probably-Erwins-Cat/E-TKT/_3dprint/source/E-TKT.FCStd

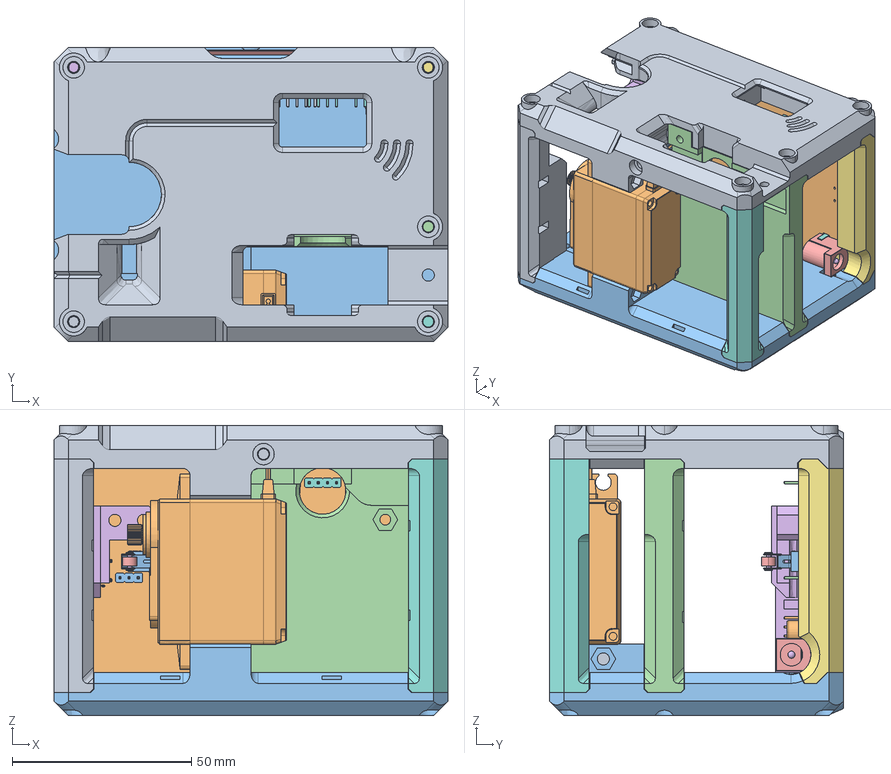
[picture p1: CAD file, 2025-10-23]
_3dprint/source/E-TKT.FCStd
110.0 x 82.0 x 81.0 mm
E-TKT_025-structure_J_top
MG-995
A_bottom
B_wall
optional-electronics-cover
F_pillar
G_pillar
D_pillar
E_pillar
C_0603_1608Metric015
LED_0603_1608Metric012
R_0603_1608Metric029
SSOP-20_3.9x8.7mm_P0.635mm001
C_0603_1608Metric016
C_0603_1608Metric017
LED_0603_1608Metric013
KEY-SMD_4P-L6.0-W6.3-H3.1-LS8.0-P4.014
KEY-SMD_4P-L6.0-W6.3-H3.1-LS8.0-P4.015
R_0603_1608Metric030
R_0603_1608Metric031
R_0603_1608Metric032
R_0603_1608Metric033
SOT-224
C_0603_1608Metric018
TDFN-6_L2.0-W2.0-H0.8-P0.65
SOT-225
C_0603_1608Metric019
C_0603_1608Metric020
C_0603_1608Metric021
KEY-SMD_4P-L6.0-W6.3-H3.1-LS8.0-P4.017
KEY-SMD_4P-L6.0-W6.3-H3.1-LS8.0-P4.018
C_0603_1608Metric022
L_0805_2012Metric001
USB-TH_GT-USB-7057A
C_1210_3225Metric008
R_0603_1608Metric034
C_1210_3225Metric009
R_0603_1608Metric035
R_0603_1608Metric036
R_0603_1608Metric037
C_0603_1608Metric023
SOT-23-007
LED_0603_1608Metric014
R_0603_1608Metric038
C_1210_3225Metric010
C_0603_1608Metric024
LED_0603_1608Metric015
C_1210_3225Metric011
Fuse_0805_2012Metric001
R_0603_1608Metric039
R_0603_1608Metric040
KEY-SMD_4P-L6.0-W6.3-H3.1-LS8.0-P4.020
KEY-SMD_4P-L6.0-W6.3-H3.1-LS8.0-P4.021
LED_0603_1608Metric016
R_0603_1608Metric041
R_0603_1608Metric042
R_0603_1608Metric043
R_0603_1608Metric044
R_0603_1608Metric045
C_0603_1608Metric025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
