probably-Erwins-Cat/E-TKT/_3dprint/source/PCB-V2-BETA.step

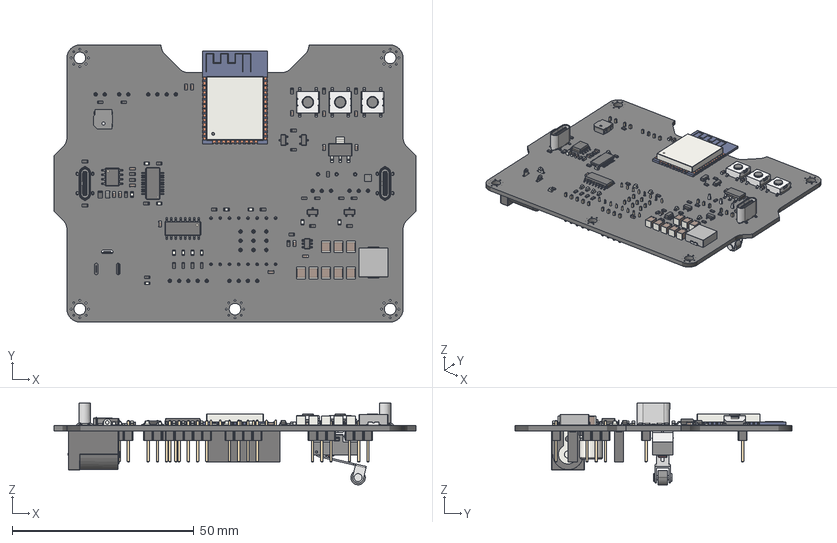
[picture p2: CAD file, 2025-10-22]
_3dprint/source/PCB-V2-BETA.step
99.6 x 76.2 x 22.5 mm
C_0603_1608Metric x 15
LED_0603_1608Metric x 12
R_0603_1608Metric x 30
SSOP-20_3.9x8.7mm_P0.635mm
KEY-SMD_4P-L6.0-W6.3-H3.1-LS8.0-P4.5 x 3
SOT-23 x 4
TDFN-6_L2.0-W2.0-H0.8-P0.65
L_0805_2012Metric
USB-TH_GT-USB-7057A x 2
C_1210_3225Metric x 8
SOT-23-6
Fuse_0805_2012Metric
SOIC-16_3.9x9.9mm_P1.27mm
SOIC-8_3.9x4.9mm_P1.27mm
IND-SMD_L8.5-W8.0_PSPMAA0803H-330M-ANP
BUZ-SMD_3P-L5.2-W5.2-H2.0-P3.50
SOT-223
ESP32-WROOM-32
PinHeader_1x03_P2.54mm_Vertical x 5
PinSocket_1x08_P2.54mm_Vertical x 2
PinHeader_1x04_P2.54mm_Vertical x 2
PinHeader_1x02_P2.54mm_Vertical x 2
BarrelJack_Horizontal
CP_Elec_6.3x7.7
PinHeader_1x05_P2.54mm_Vertical
e-tkt_PCB
