probably-Erwins-Cat/E-TKT/_electronic/e-tkt.kicad_pcb

## KiCad design _electronic/e-tkt.kicad_pcb (2025-10-24)

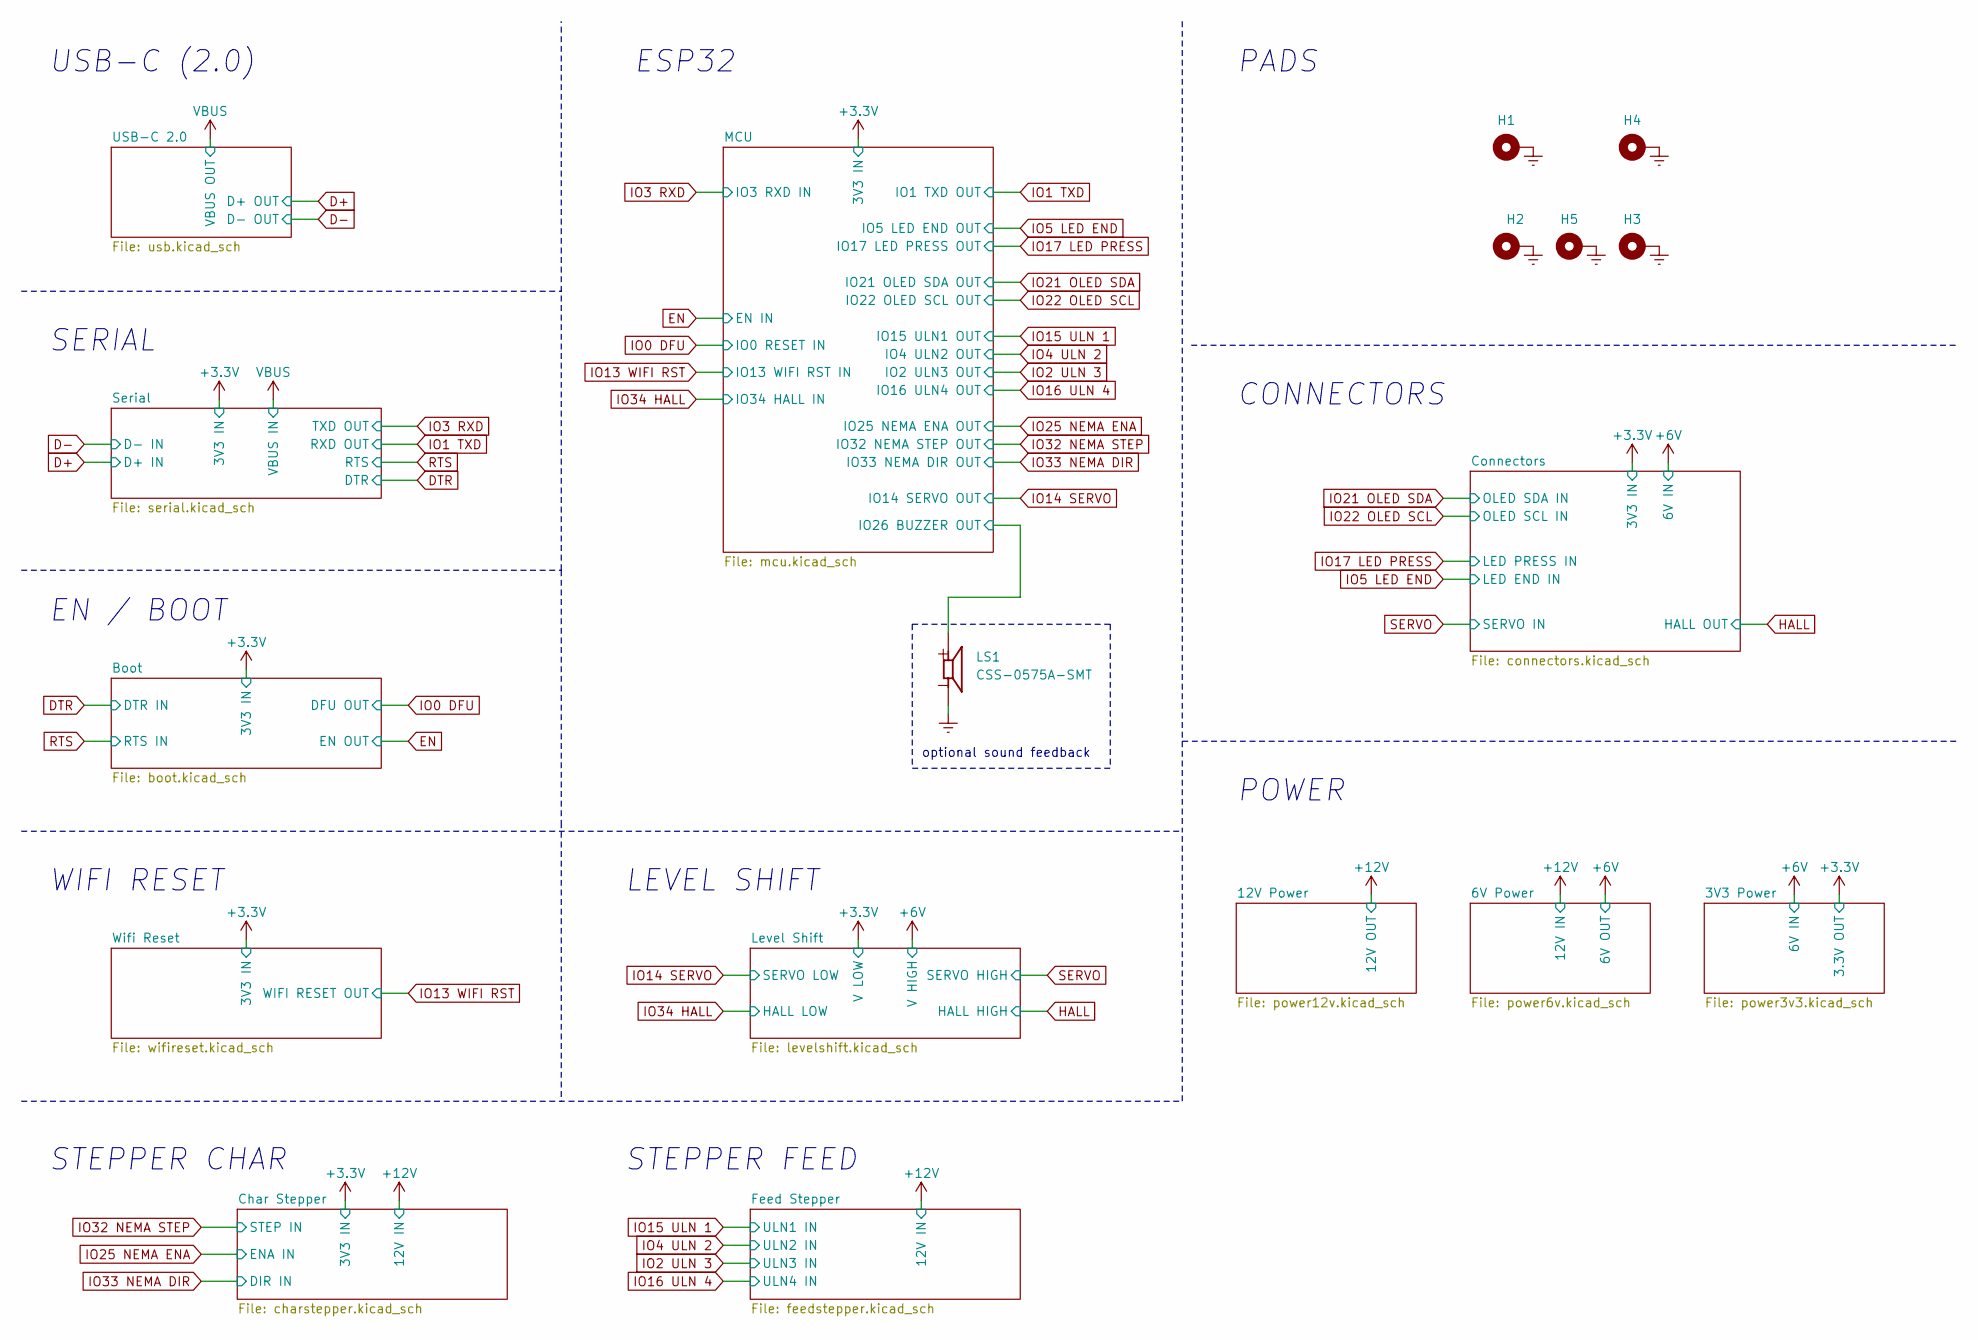
[picture p4: schematic e-tkt.kicad_sch, E-TKT v2.0 BETA]

Parts:
H1, H2, H3, H4, H5: M3; MountingHole_3.2mm_M3_Pad_Via; Mouser OK
LS1: CSS-0575A-SMT; BUZ-SMD_L5.0-W5.5-P4.60; Mouser OK

Connections:
/MCU/IO26 BUZZER OUT: LS1.1; also elsewhere on the board
GNDREF: H1.1, H2.1, H3.1, H4.1, H5.1, LS1.2; also elsewhere on the board

Notes on the sheet:
PADS
POWER
optional sound feedback
SERIAL
EN / BOOT
CONNECTORS
STEPPER CHAR
WIFI RESET
ESP32
LEVEL SHIFT
STEPPER FEED
USB-C (2.0)

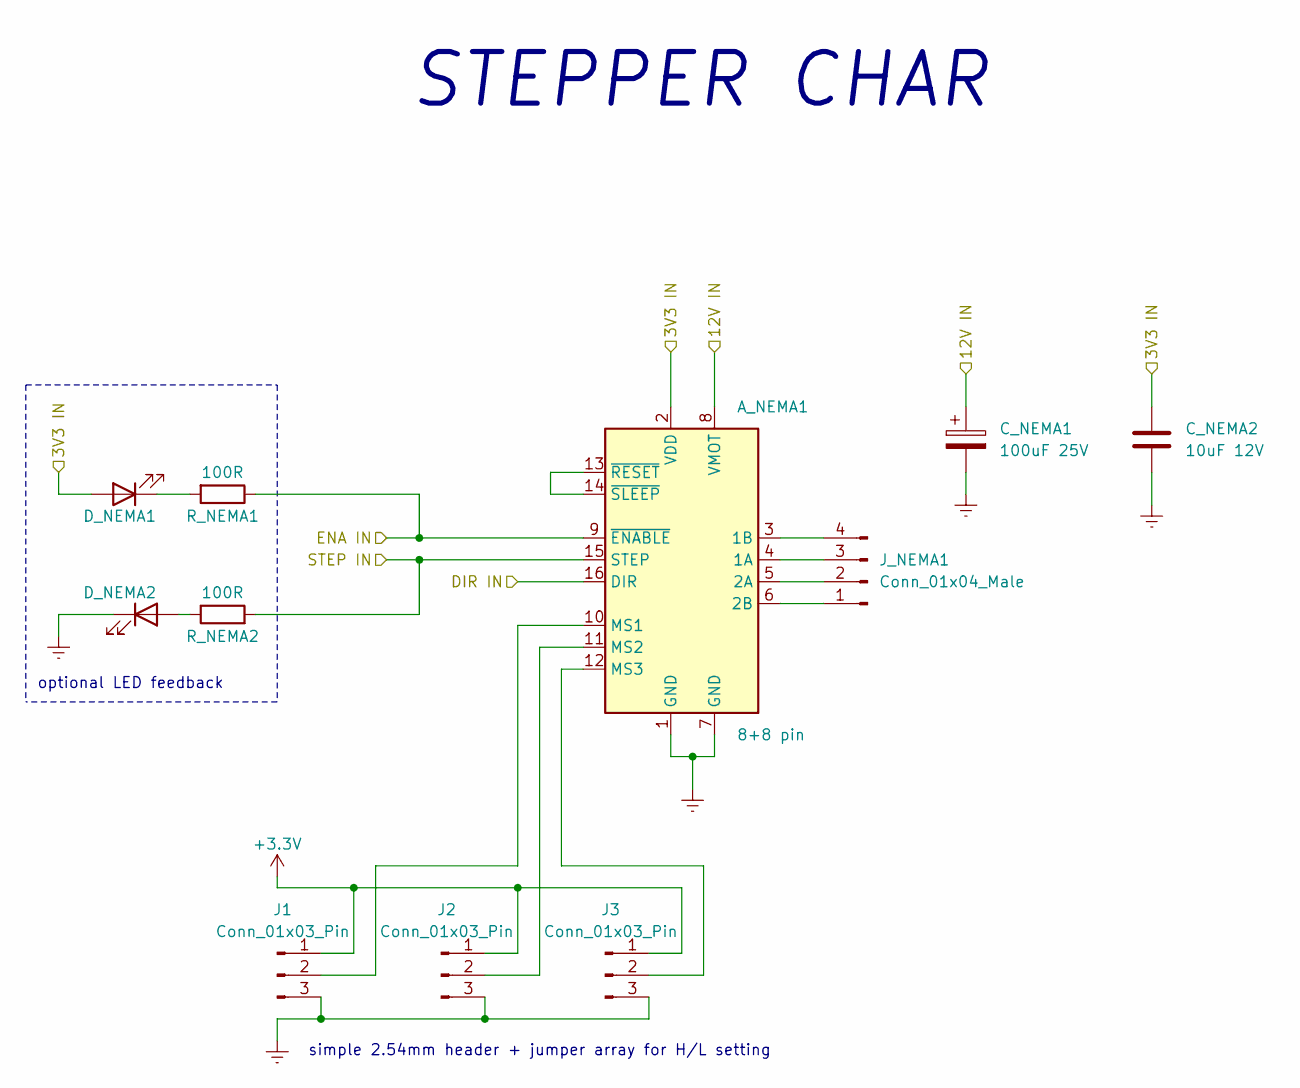
[picture p5: schematic charstepper.kicad_sch, E-TKT v2.0 BETA]

Parts:
A_NEMA1: 8+8 pin; Pololu_Breakout-16_15.2x20.3mm; Mouser OK
C_NEMA1: 100uF 25V; CP_Elec_6.3x7.7; Mouser OK
C_NEMA2: 10uF 12V; C_0603_1608Metric_Pad1.08x0.95mm_HandSolder; Mouser OK
D_NEMA1, D_NEMA2: LED white; LED_0603_1608Metric_Pad1.05x0.95mm_HandSolder; Mouser OK
J1, J2, J3: Conn_01x03_Pin; PinHeader_1x03_P2.54mm_Vertical; LCSC C2937625
J_NEMA1: Conn_01x04_Male; PinHeader_1x04_P2.54mm_Vertical; Mouser OK
R_NEMA1, R_NEMA2: 100R; R_0603_1608Metric_Pad0.98x0.95mm_HandSolder; Mouser OK

Connections:
+3.3V: A_NEMA1.2 (VDD), C_NEMA2.2, D_NEMA1.2 (A), J1.1, J2.1, J3.1; also elsewhere on the board
+12V: A_NEMA1.8 (VMOT), C_NEMA1.1; also elsewhere on the board
GNDREF: A_NEMA1.1 (GND), A_NEMA1.7 (GND), C_NEMA1.2, C_NEMA2.1, D_NEMA2.1 (K), J1.3, J2.3, J3.3; also elsewhere on the board
IO25 NEMA ENA: A_NEMA1.9 (~ENABLE), R_NEMA1.1; also elsewhere on the board
IO32 NEMA STEP: A_NEMA1.15 (STEP), R_NEMA2.2; also elsewhere on the board
IO33 NEMA DIR: A_NEMA1.16 (DIR); also elsewhere on the board
unnamed: A_NEMA1.4 (1A), J_NEMA1.3
unnamed: A_NEMA1.3 (1B), J_NEMA1.4
unnamed: A_NEMA1.5 (2A), J_NEMA1.2
unnamed: A_NEMA1.6 (2B), J_NEMA1.1
unnamed: A_NEMA1.10 (MS1), J1.2
unnamed: A_NEMA1.11 (MS2), J2.2
unnamed: A_NEMA1.12 (MS3), J3.2
unnamed: A_NEMA1.13 (~RESET), A_NEMA1.14 (~SLEEP)
unnamed: D_NEMA1.1 (K), R_NEMA1.2
unnamed: D_NEMA2.2 (A), R_NEMA2.1

Notes on the sheet:
optional LED feedback
simple 2.54mm header + jumper array for H/L setting
STEPPER CHAR

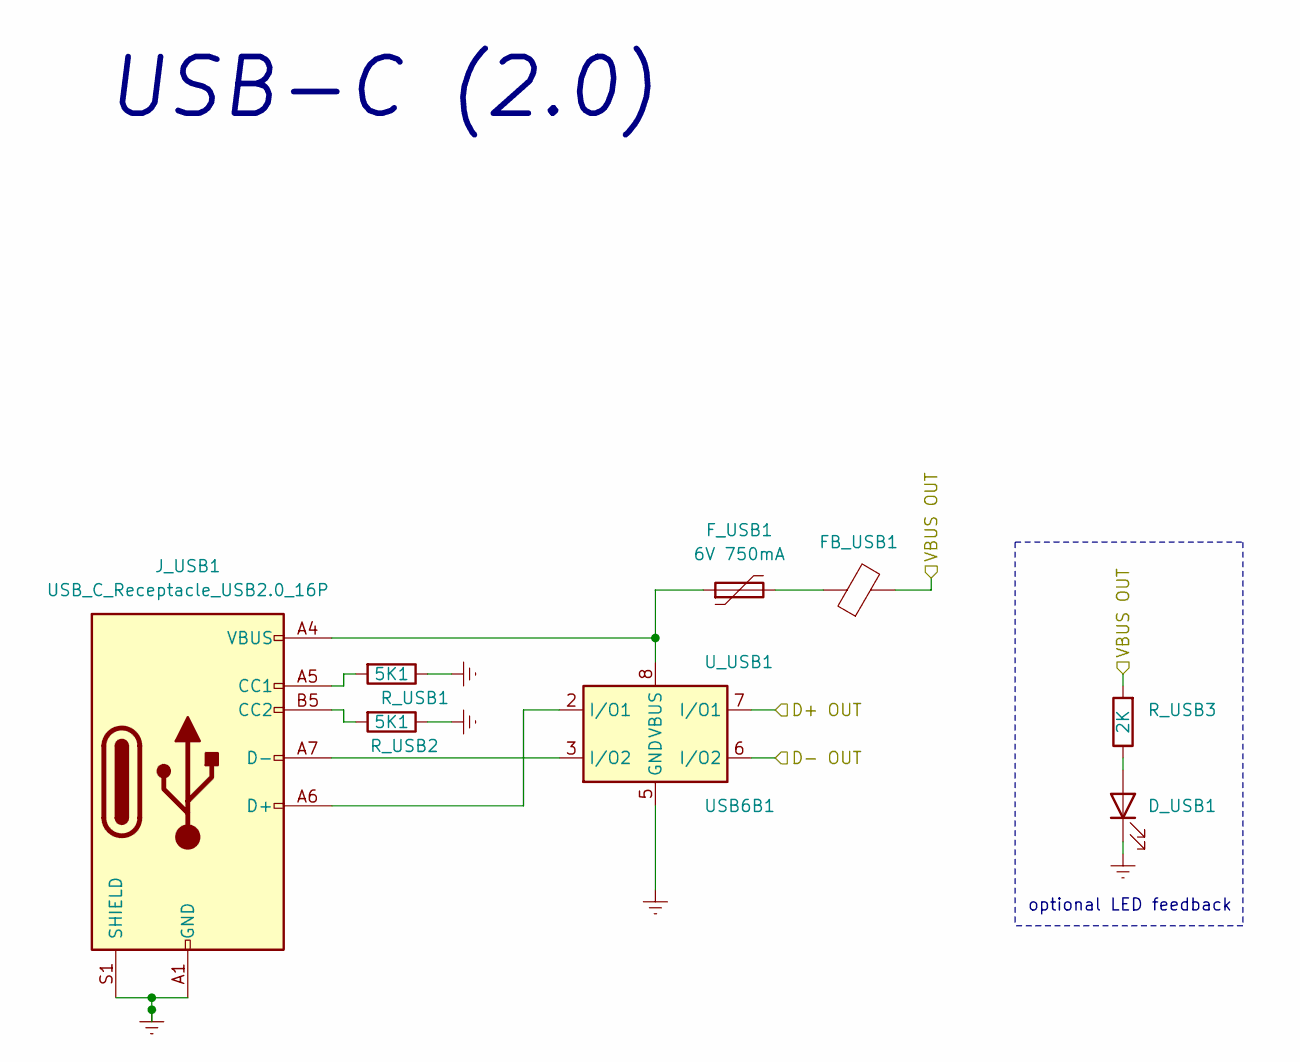
[picture p6: schematic usb.kicad_sch, E-TKT v2.0 BETA]

Parts:
D_USB1: LED white; LED_0603_1608Metric_Pad1.05x0.95mm_HandSolder; Mouser OK
FB_USB1: 40 Ohms @ 100 MHz 1 Power; L_0805_2012Metric_Pad1.05x1.20mm_HandSolder; Mouser OK
F_USB1: 6V 750mA; Fuse_0805_2012Metric_Pad1.15x1.40mm_HandSolder; Mouser OK
J_USB1: USB_C_Receptacle_USB2.0_16P; USB-TH_GT-USB-7057A; LCSC C22383830
R_USB1, R_USB2: 5K1; R_0603_1608Metric_Pad0.98x0.95mm_HandSolder; Mouser OK
R_USB3: 2K; R_0603_1608Metric_Pad0.98x0.95mm_HandSolder; Mouser OK
U_USB1: USB6B1; SOIC-8_3.9x4.9mm_P1.27mm; Mouser OK

Connections:
D+: U_USB1.7 (I/O1); also elsewhere on the board
D-: U_USB1.6 (I/O2); also elsewhere on the board
GNDREF: D_USB1.1 (K), J_USB1.A1 (GND), J_USB1.S1 (SHIELD), R_USB1.1, R_USB2.1, U_USB1.4 (GND), U_USB1.5 (GND); also elsewhere on the board
unnamed: D_USB1.2 (A), R_USB3.1
unnamed: FB_USB1.1, F_USB1.2
unnamed: F_USB1.1, J_USB1.A4 (VBUS), U_USB1.1 (VBUS), U_USB1.8 (VBUS)
unnamed: J_USB1.A5 (CC1), R_USB1.2
unnamed: J_USB1.B5 (CC2), R_USB2.2
unnamed: J_USB1.A6 (D+), U_USB1.2 (I/O1)
unnamed: J_USB1.A7 (D-), U_USB1.3 (I/O2)
VBUS: FB_USB1.2, R_USB3.2; also elsewhere on the board

Notes on the sheet:
USB-C (2.0)
optional LED feedback

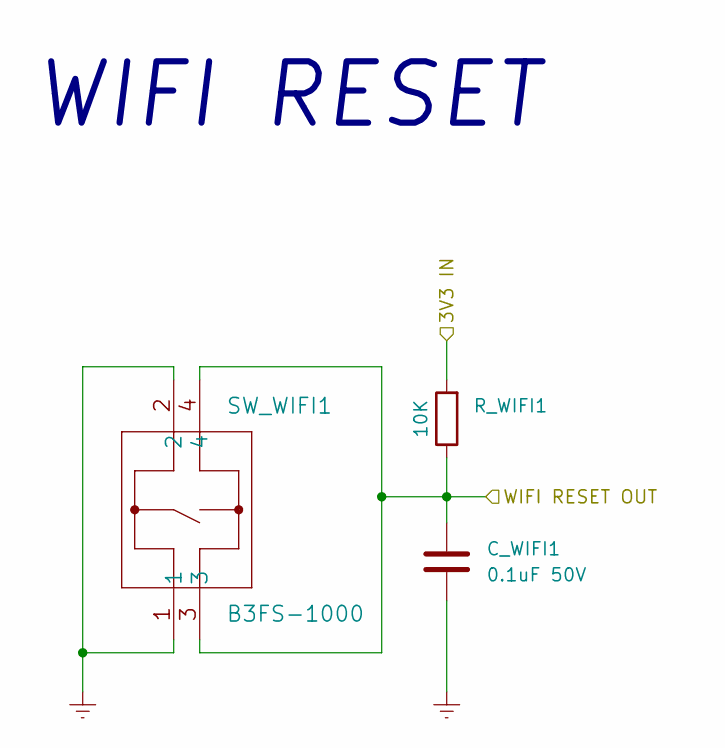
[picture p7: schematic wifireset.kicad_sch, E-TKT v2.0 BETA]

Parts:
C_WIFI1: 0.1uF 50V; C_0603_1608Metric_Pad1.08x0.95mm_HandSolder; Mouser OK
R_WIFI1: 10K; R_0603_1608Metric_Pad0.98x0.95mm_HandSolder; Mouser OK
SW_WIFI1: B3FS-1000; KEY-SMD_4P-L6.0-W6.3-P4.50-LS8.0; Mouser OK

Connections:
+3.3V: R_WIFI1.2; also elsewhere on the board
GNDREF: C_WIFI1.1, SW_WIFI1.1, SW_WIFI1.2; also elsewhere on the board
IO13 WIFI RST: C_WIFI1.2, R_WIFI1.1, SW_WIFI1.3, SW_WIFI1.4; also elsewhere on the board

Notes on the sheet:
WIFI RESET

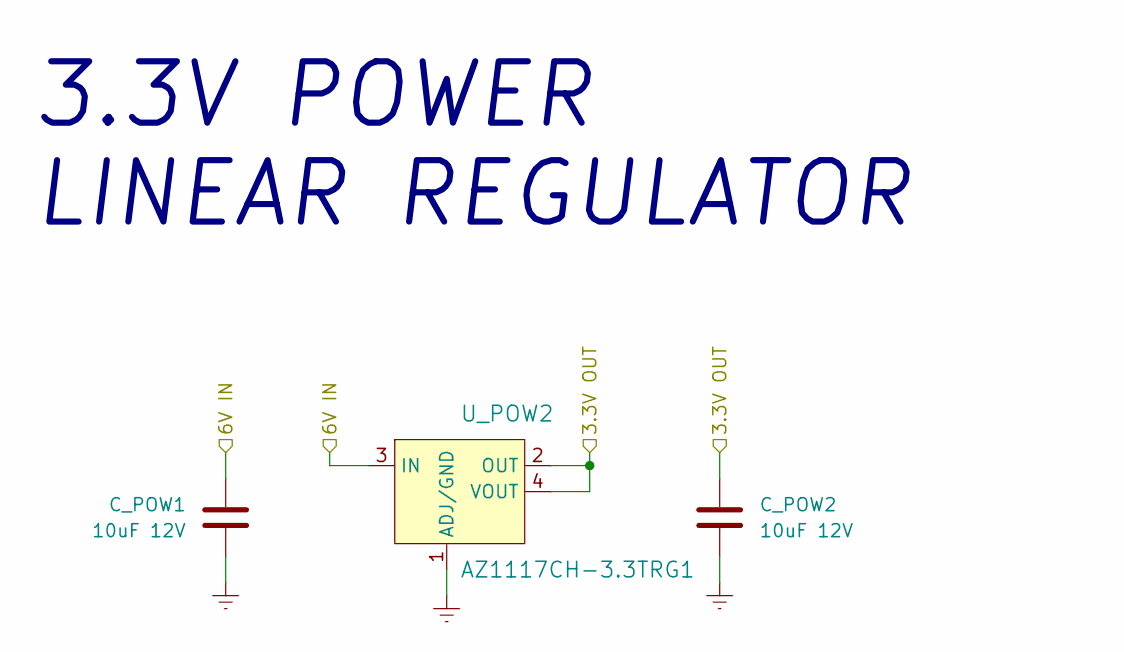
[picture p8: schematic power3v3.kicad_sch, E-TKT v2.0 BETA]

Parts:
C_POW1, C_POW2: 10uF 12V; C_0603_1608Metric_Pad1.08x0.95mm_HandSolder; Mouser OK
U_POW2: AZ1117CH-3.3TRG1; SOT-223; Mouser OK

Connections:
+3.3V: C_POW2.1, U_POW2.2 (OUT), U_POW2.4 (VOUT); also elsewhere on the board
+6V: C_POW1.1, U_POW2.3 (IN); also elsewhere on the board
GNDREF: C_POW1.2, C_POW2.2, U_POW2.1 (ADJ/GND); also elsewhere on the board

Notes on the sheet:
3.3V POWER LINEAR REGULATOR

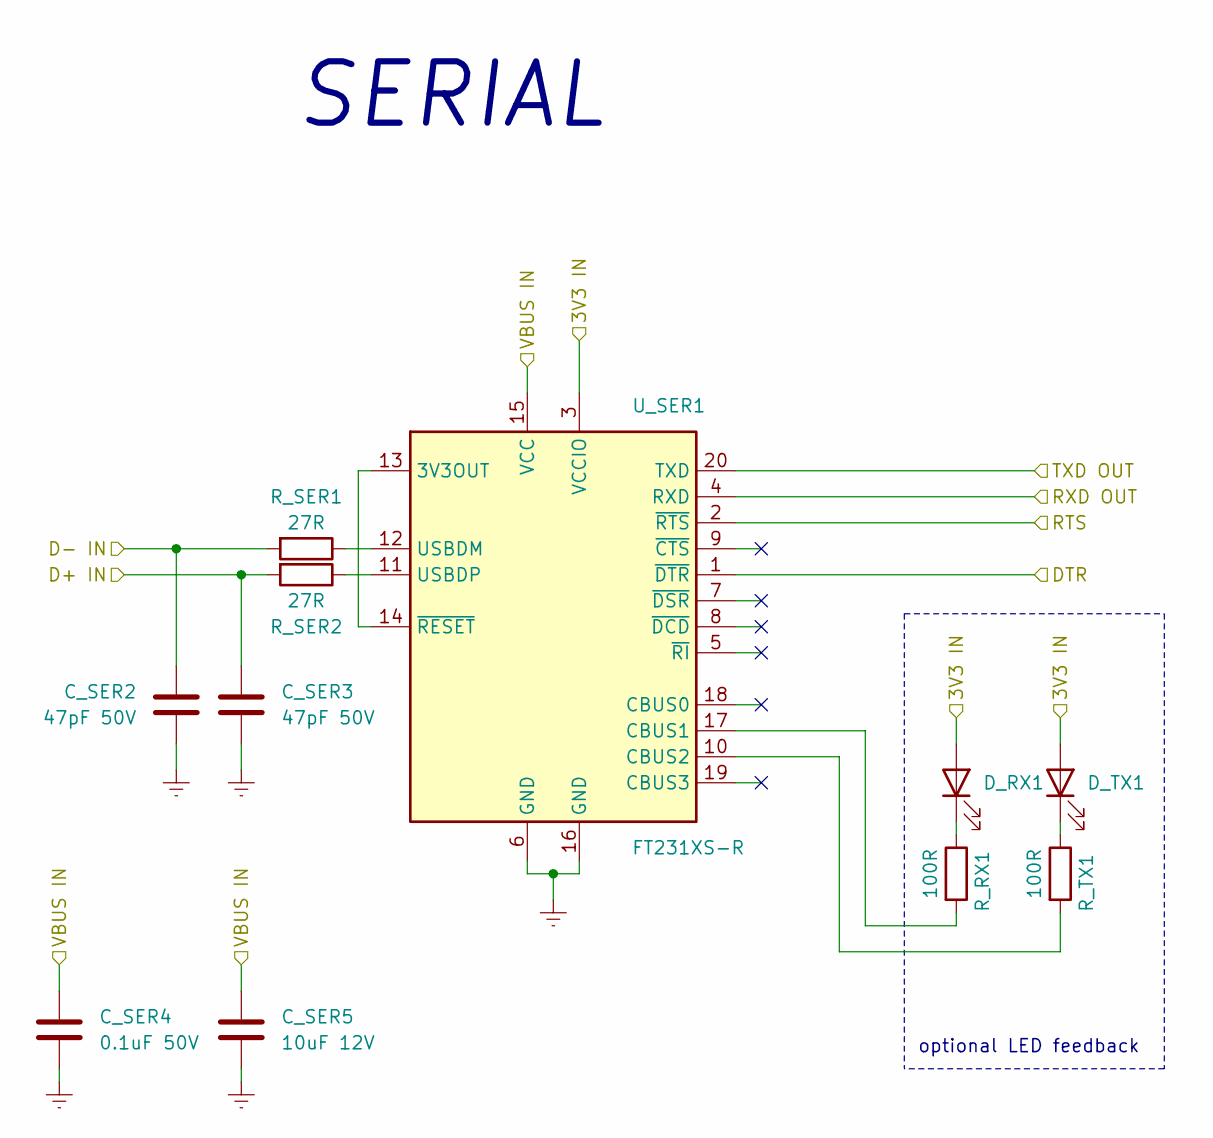
[picture p9: schematic serial.kicad_sch, E-TKT v2.0 BETA]

Parts:
C_SER2, C_SER3: 47pF 50V; C_0603_1608Metric_Pad1.08x0.95mm_HandSolder; Mouser OK
C_SER4: 0.1uF 50V; C_0603_1608Metric_Pad1.08x0.95mm_HandSolder; Mouser OK
C_SER5: 10uF 12V; C_0603_1608Metric_Pad1.08x0.95mm_HandSolder; Mouser OK
D_RX1: LED white; LED_0603_1608Metric_Pad1.05x0.95mm_HandSolder; Mouser OK
D_TX1: LED white; LED_0603_1608Metric_Pad1.05x0.95mm_HandSolder; Mouser OK
R_RX1: 100R; R_0603_1608Metric_Pad0.98x0.95mm_HandSolder; Mouser OK
R_SER1, R_SER2: 27R; R_0603_1608Metric_Pad0.98x0.95mm_HandSolder; Mouser OK
R_TX1: 100R; R_0603_1608Metric_Pad0.98x0.95mm_HandSolder; Mouser OK
U_SER1: FT231XS-R; SSOP-20_3.9x8.7mm_P0.635mm; Mouser OK

Connections:
+3.3V: D_RX1.2 (A), D_TX1.2 (A), U_SER1.3 (VCCIO); also elsewhere on the board
D+: C_SER3.2, R_SER2.2; also elsewhere on the board
D-: C_SER2.2, R_SER1.2; also elsewhere on the board
DTR: U_SER1.1 (~DTR); also elsewhere on the board
GNDREF: C_SER2.1, C_SER3.1, C_SER4.2, C_SER5.1, U_SER1.6 (GND), U_SER1.16 (GND); also elsewhere on the board
IO1 TXD: U_SER1.4 (RXD); also elsewhere on the board
IO3 RXD: U_SER1.20 (TXD); also elsewhere on the board
unnamed: D_RX1.1 (K), R_RX1.1
unnamed: D_TX1.1 (K), R_TX1.1
unnamed: U_SER1.13 (3V3OUT), U_SER1.14 (~RESET)
unnamed: R_RX1.2, U_SER1.17 (CBUS1)
unnamed: R_TX1.2, U_SER1.10 (CBUS2)
unnamed: R_SER1.1, U_SER1.12 (USBDM)
unnamed: R_SER2.1, U_SER1.11 (USBDP)
RTS: U_SER1.2 (~RTS); also elsewhere on the board
VBUS: C_SER4.1, C_SER5.2, U_SER1.15 (VCC); also elsewhere on the board

Notes on the sheet:
SERIAL
optional LED feedback

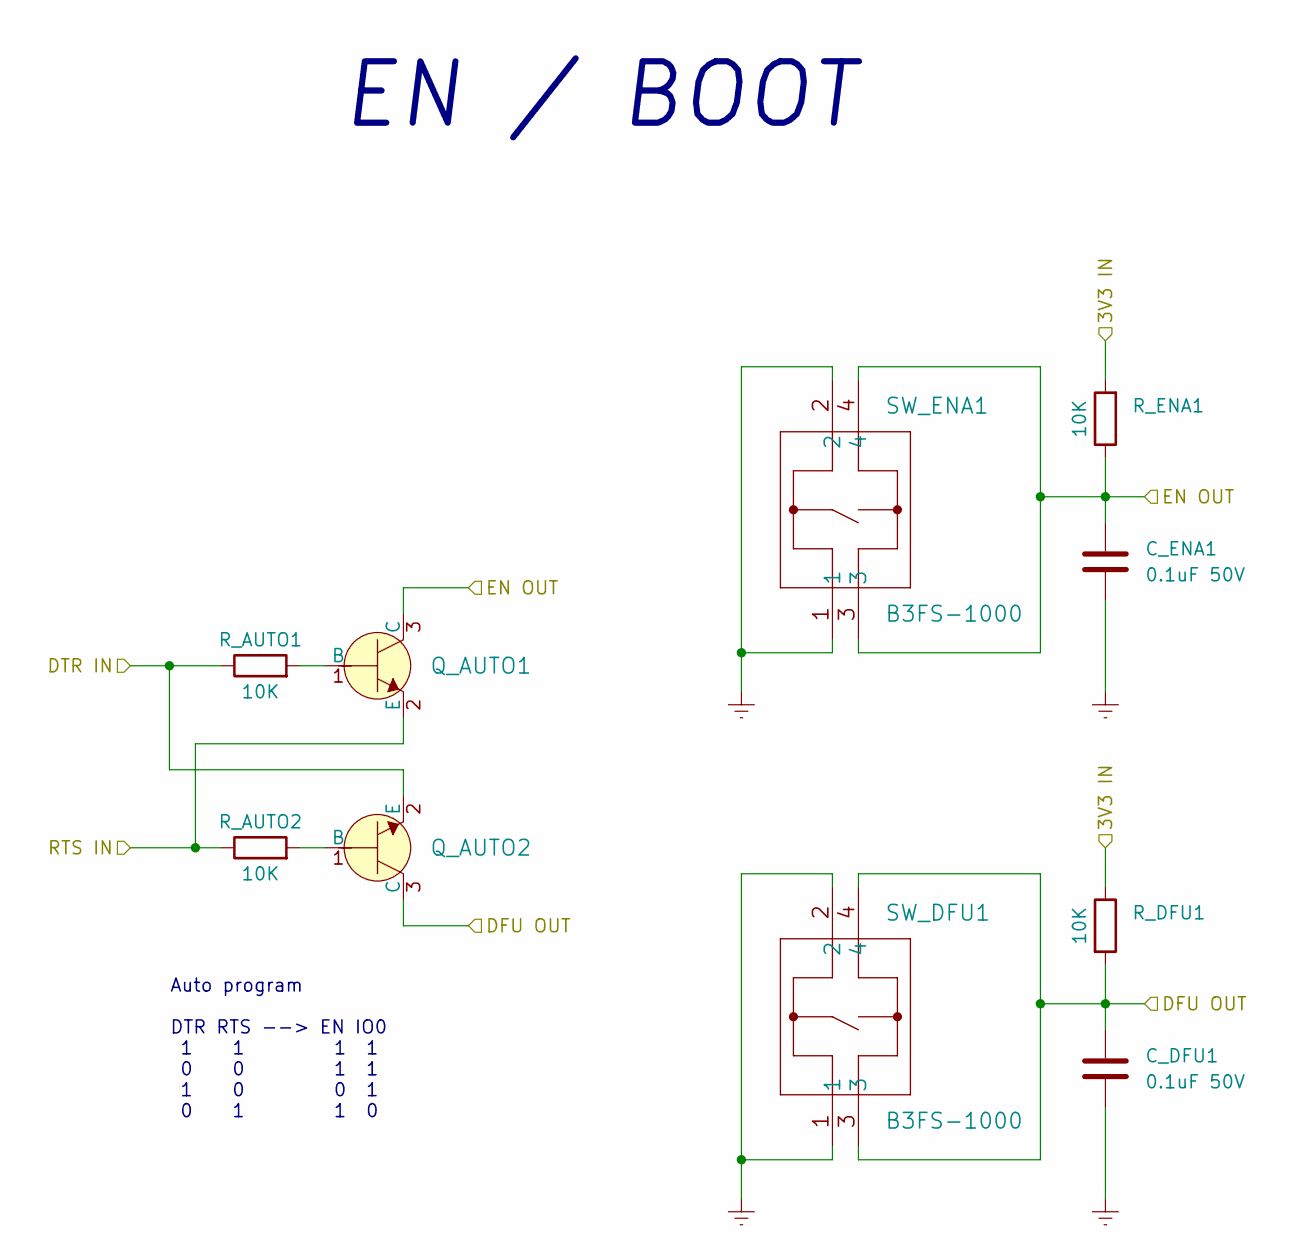
[picture p10: schematic boot.kicad_sch, E-TKT v2.0 BETA]

Parts:
C_DFU1: 0.1uF 50V; C_0603_1608Metric_Pad1.08x0.95mm_HandSolder; Mouser OK
C_ENA1: 0.1uF 50V; C_0603_1608Metric_Pad1.08x0.95mm_HandSolder; Mouser OK
Q_AUTO1, Q_AUTO2: SS8050; SOT-23_Handsoldering; Mouser OK
R_AUTO1, R_AUTO2: 10K; R_0603_1608Metric_Pad0.98x0.95mm_HandSolder; Mouser OK
R_DFU1: 10K; R_0603_1608Metric_Pad0.98x0.95mm_HandSolder; Mouser OK
R_ENA1: 10K; R_0603_1608Metric_Pad0.98x0.95mm_HandSolder; Mouser OK
SW_DFU1: B3FS-1000; KEY-SMD_4P-L6.0-W6.3-P4.50-LS8.0; Mouser OK
SW_ENA1: B3FS-1000; KEY-SMD_4P-L6.0-W6.3-P4.50-LS8.0; Mouser OK

Connections:
+3.3V: R_DFU1.1, R_ENA1.2; also elsewhere on the board
DTR: Q_AUTO2.2 (E), R_AUTO1.1; also elsewhere on the board
EN: C_ENA1.2, Q_AUTO1.3 (C), R_ENA1.1, SW_ENA1.3, SW_ENA1.4; also elsewhere on the board
GNDREF: C_DFU1.1, C_ENA1.1, SW_DFU1.1, SW_DFU1.2, SW_ENA1.1, SW_ENA1.2; also elsewhere on the board
IO0 DFU: C_DFU1.2, Q_AUTO2.3 (C), R_DFU1.2, SW_DFU1.3, SW_DFU1.4; also elsewhere on the board
unnamed: Q_AUTO1.1 (B), R_AUTO1.2
unnamed: Q_AUTO2.1 (B), R_AUTO2.2
RTS: Q_AUTO1.2 (E), R_AUTO2.1; also elsewhere on the board

Notes on the sheet:
Auto program DTR RTS --> EN IO0 1 1 1 1 0 0 1 1 1 0 0 1 0 1 1 0
EN / BOOT

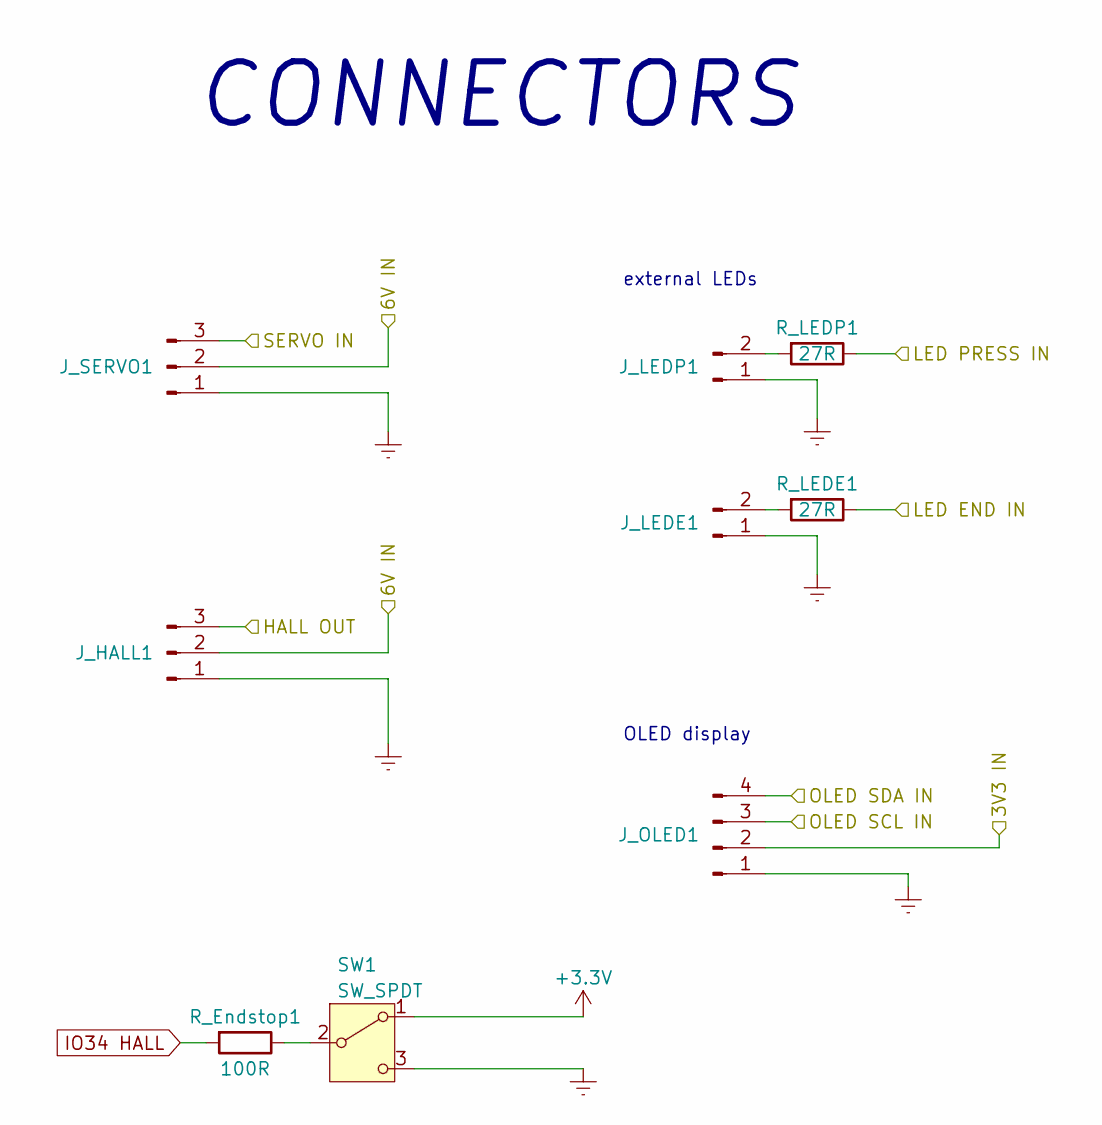
[picture p11: schematic connectors.kicad_sch, E-TKT v2.0 BETA]

Parts:
J_HALL1: Conn_01x03_Female; PinHeader_1x03_P2.54mm_Vertical; Mouser OK
J_LEDE1: Conn_01x02_Male; PinHeader_1x02_P2.54mm_Vertical; Mouser OK
J_LEDP1: Conn_01x02_Male; PinHeader_1x02_P2.54mm_Vertical; Mouser OK
J_OLED1: Conn_01x04_Male; PinHeader_1x04_P2.54mm_Vertical; Mouser OK
J_SERVO1: Conn_01x03_Male; PinHeader_1x03_P2.54mm_Vertical; Mouser OK
R_Endstop1: 100R; R_0603_1608Metric_Pad0.98x0.95mm_HandSolder; Mouser OK
R_LEDE1: 27R; R_0603_1608Metric_Pad0.98x0.95mm_HandSolder; Mouser OK
R_LEDP1: 27R; R_0603_1608Metric_Pad0.98x0.95mm_HandSolder; Mouser OK
SW1: SW_SPDT; SW-TH_JL010; LCSC C2681582

Connections:
+3.3V: J_OLED1.2, SW1.1 (A); also elsewhere on the board
+6V: J_HALL1.2, J_SERVO1.2; also elsewhere on the board
GNDREF: J_HALL1.1, J_LEDE1.1, J_LEDP1.1, J_OLED1.1, J_SERVO1.1, SW1.3 (C); also elsewhere on the board
HALL: J_HALL1.3; also elsewhere on the board
IO5 LED END: R_LEDE1.1; also elsewhere on the board
IO17 LED PRESS: R_LEDP1.1; also elsewhere on the board
IO21 OLED SDA: J_OLED1.4; also elsewhere on the board
IO22 OLED SCL: J_OLED1.3; also elsewhere on the board
IO34 HALL: R_Endstop1.2; also elsewhere on the board
unnamed: J_LEDE1.2, R_LEDE1.2
unnamed: J_LEDP1.2, R_LEDP1.2
unnamed: R_Endstop1.1, SW1.2 (B)
SERVO: J_SERVO1.3; also elsewhere on the board

Notes on the sheet:
OLED display
CONNECTORS
external LEDs

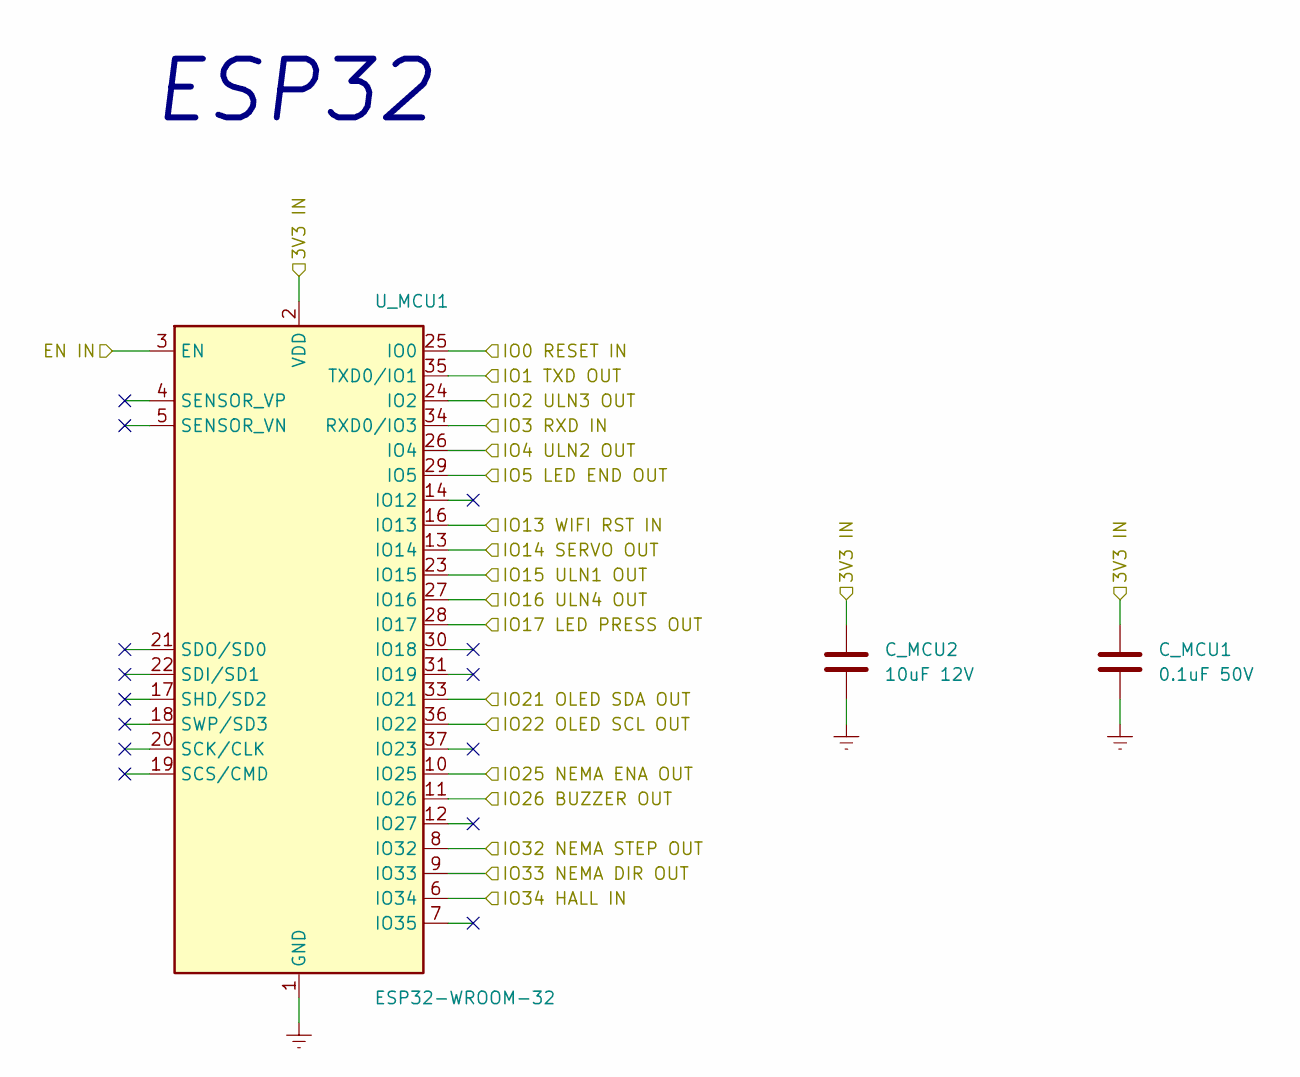
[picture p12: schematic mcu.kicad_sch, E-TKT v2.0 BETA]

Parts:
C_MCU1: 0.1uF 50V; C_0603_1608Metric_Pad1.08x0.95mm_HandSolder; Mouser OK
C_MCU2: 10uF 12V; C_0603_1608Metric_Pad1.08x0.95mm_HandSolder; Mouser OK
U_MCU1: ESP32-WROOM-32; Mouser OK

Connections:
+3.3V: C_MCU1.1, C_MCU2.2, U_MCU1.2 (VDD); also elsewhere on the board
/MCU/IO26 BUZZER OUT: U_MCU1.11 (IO26); also elsewhere on the board
EN: U_MCU1.3 (EN); also elsewhere on the board
GNDREF: C_MCU1.2, C_MCU2.1, U_MCU1.1 (GND), U_MCU1.15 (GND), U_MCU1.38 (GND), U_MCU1.39 (GND); also elsewhere on the board
IO0 DFU: U_MCU1.25 (IO0); also elsewhere on the board
IO1 TXD: U_MCU1.35 (TXD0/IO1); also elsewhere on the board
IO2 ULN 3: U_MCU1.24 (IO2); also elsewhere on the board
IO3 RXD: U_MCU1.34 (RXD0/IO3); also elsewhere on the board
IO4 ULN 2: U_MCU1.26 (IO4); also elsewhere on the board
IO5 LED END: U_MCU1.29 (IO5); also elsewhere on the board
IO13 WIFI RST: U_MCU1.16 (IO13); also elsewhere on the board
IO14 SERVO: U_MCU1.13 (IO14); also elsewhere on the board
IO15 ULN 1: U_MCU1.23 (IO15); also elsewhere on the board
IO16 ULN 4: U_MCU1.27 (IO16); also elsewhere on the board
IO17 LED PRESS: U_MCU1.28 (IO17); also elsewhere on the board
IO21 OLED SDA: U_MCU1.33 (IO21); also elsewhere on the board
IO22 OLED SCL: U_MCU1.36 (IO22); also elsewhere on the board
IO25 NEMA ENA: U_MCU1.10 (IO25); also elsewhere on the board
IO32 NEMA STEP: U_MCU1.8 (IO32); also elsewhere on the board
IO33 NEMA DIR: U_MCU1.9 (IO33); also elsewhere on the board
IO34 HALL: U_MCU1.6 (IO34); also elsewhere on the board

Notes on the sheet:
ESP32

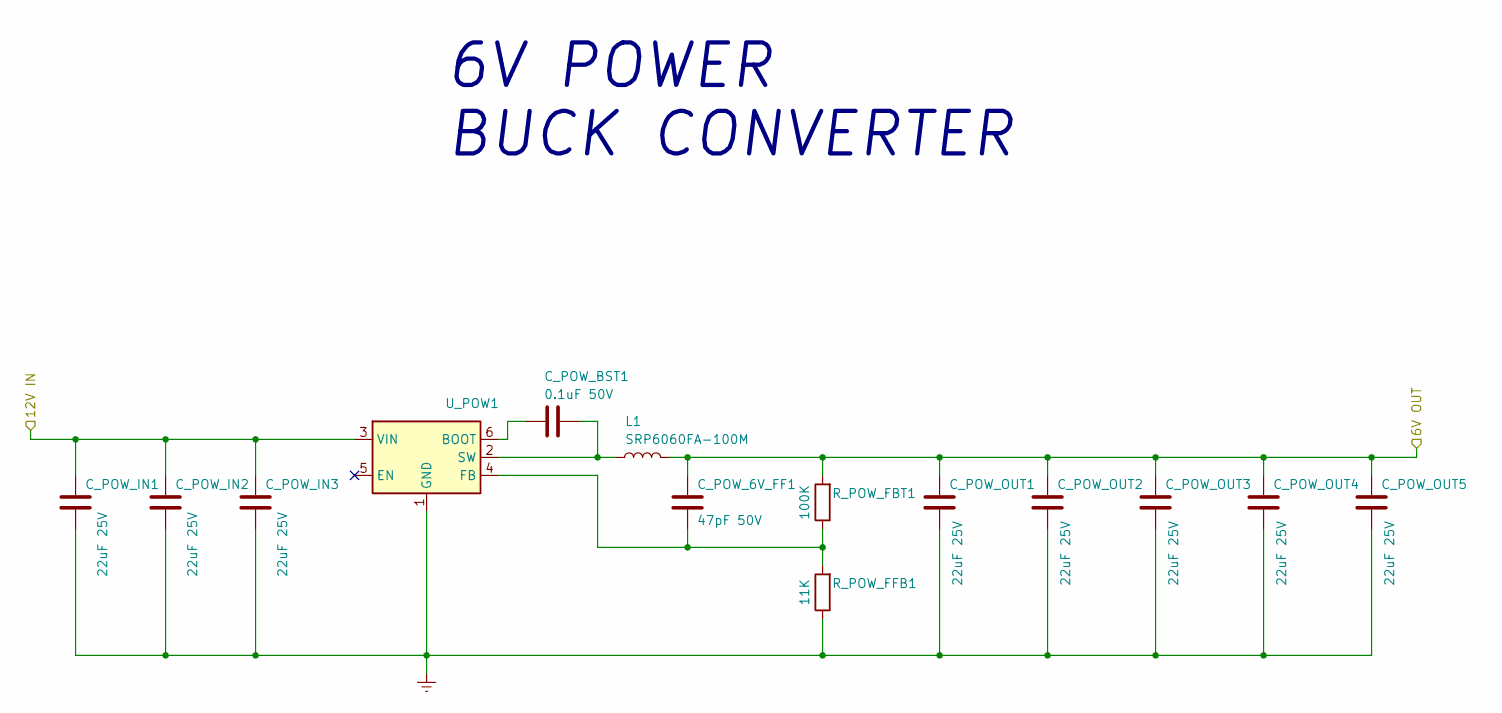
[picture p13: schematic power6v.kicad_sch, E-TKT v2.0 BETA]

Parts:
C_POW_6V_FF1: 47pF 50V; C_0603_1608Metric_Pad1.08x0.95mm_HandSolder; Mouser OK
C_POW_BST1: 0.1uF 50V; C_0603_1608Metric_Pad1.08x0.95mm_HandSolder; Mouser OK
C_POW_IN1, C_POW_IN2, C_POW_IN3: 22uF 25V; C_1210_3225Metric_Pad1.33x2.70mm_HandSolder; Mouser OK
C_POW_OUT1, C_POW_OUT2, C_POW_OUT3, C_POW_OUT4, C_POW_OUT5: 22uF 25V; C_1210_3225Metric_Pad1.33x2.70mm_HandSolder; Mouser OK
L1: SRP6060FA-100M; IND-SMD_L8.5-W8.0_PSPMAA0803H-330M-ANP; Mouser OK
R_POW_FBT1: 100K; R_0603_1608Metric_Pad0.98x0.95mm_HandSolder; Mouser OK
R_POW_FFB1: 11K; R_0603_1608Metric_Pad0.98x0.95mm_HandSolder; Mouser OK
U_POW1: SOT-23-6_Handsoldering; Mouser N

Connections:
+6V: C_POW_6V_FF1.1, C_POW_OUT1.1, C_POW_OUT2.1, C_POW_OUT3.1, C_POW_OUT4.1, C_POW_OUT5.1, L1.2, R_POW_FBT1.2; also elsewhere on the board
+12V: C_POW_IN1.1, C_POW_IN2.1, C_POW_IN3.1, U_POW1.3 (VIN); also elsewhere on the board
GNDREF: C_POW_IN1.2, C_POW_IN2.2, C_POW_IN3.2, C_POW_OUT1.2, C_POW_OUT2.2, C_POW_OUT3.2, C_POW_OUT4.2, C_POW_OUT5.2, R_POW_FFB1.1, U_POW1.1 (GND); also elsewhere on the board
unnamed: C_POW_BST1.1, U_POW1.6 (BOOT)
unnamed: C_POW_6V_FF1.2, R_POW_FBT1.1, R_POW_FFB1.2, U_POW1.4 (FB)
unnamed: C_POW_BST1.2, L1.1, U_POW1.2 (SW)

Notes on the sheet:
6V POWER BUCK CONVERTER

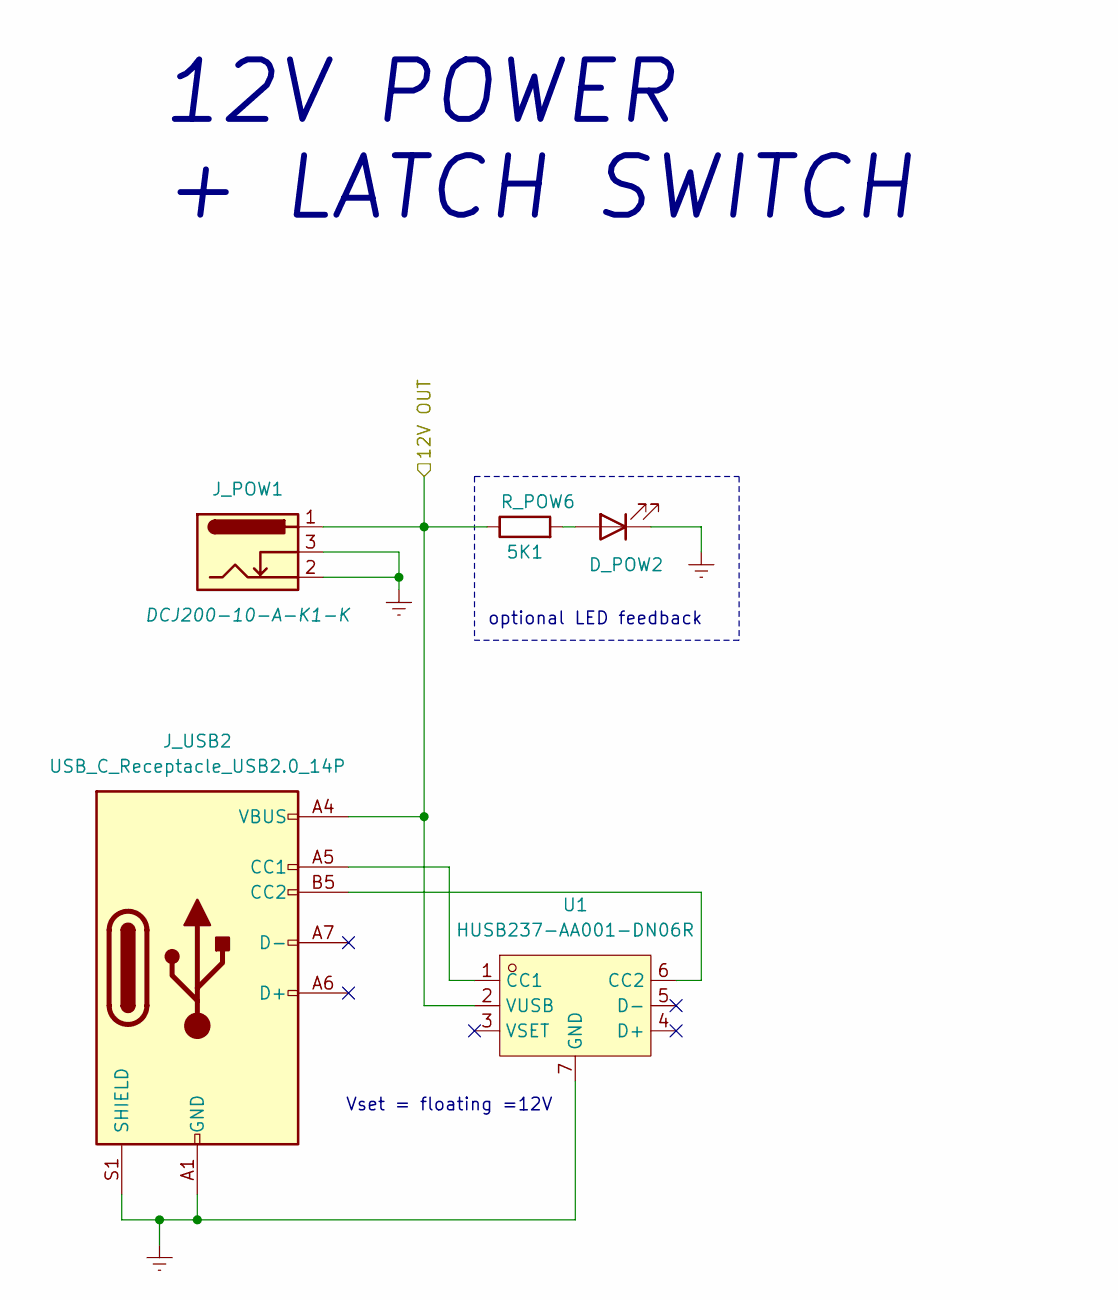
[picture p14: schematic power12v.kicad_sch, E-TKT v2.0 BETA]

Parts:
D_POW2: LED white; LED_0603_1608Metric_Pad1.05x0.95mm_HandSolder; Mouser OK
J_POW1: Barrel_Jack_Switch; BarrelJack_Horizontal; Mouser OK
J_USB2: USB_C_Receptacle_USB2.0_14P; USB-TH_GT-USB-7057A; LCSC C22383830
R_POW6: 5K1; R_0603_1608Metric_Pad0.98x0.95mm_HandSolder; Mouser OK
U1: HUSB237-AA001-DN06R; TDFN-6_L2.0-W2.0-P0.65-TL-EP; LCSC Part C22373734

Connections:
+12V: J_POW1.1, J_USB2.A4 (VBUS), R_POW6.1, U1.2 (VUSB); also elsewhere on the board
GNDREF: D_POW2.1 (K), J_POW1.2, J_POW1.3, J_USB2.A1 (GND), J_USB2.S1 (SHIELD), U1.7 (GND); also elsewhere on the board
unnamed: D_POW2.2 (A), R_POW6.2
unnamed: J_USB2.A5 (CC1), U1.1 (CC1)
unnamed: J_USB2.B5 (CC2), U1.6 (CC2)

Notes on the sheet:
Vset = floating =12V
optional LED feedback
12V POWER + LATCH SWITCH
