probably-Erwins-Cat/E-TKT/_electronic/e-tkt.kicad_pcb

## KiCad design _electronic/e-tkt.kicad_pcb (continued)

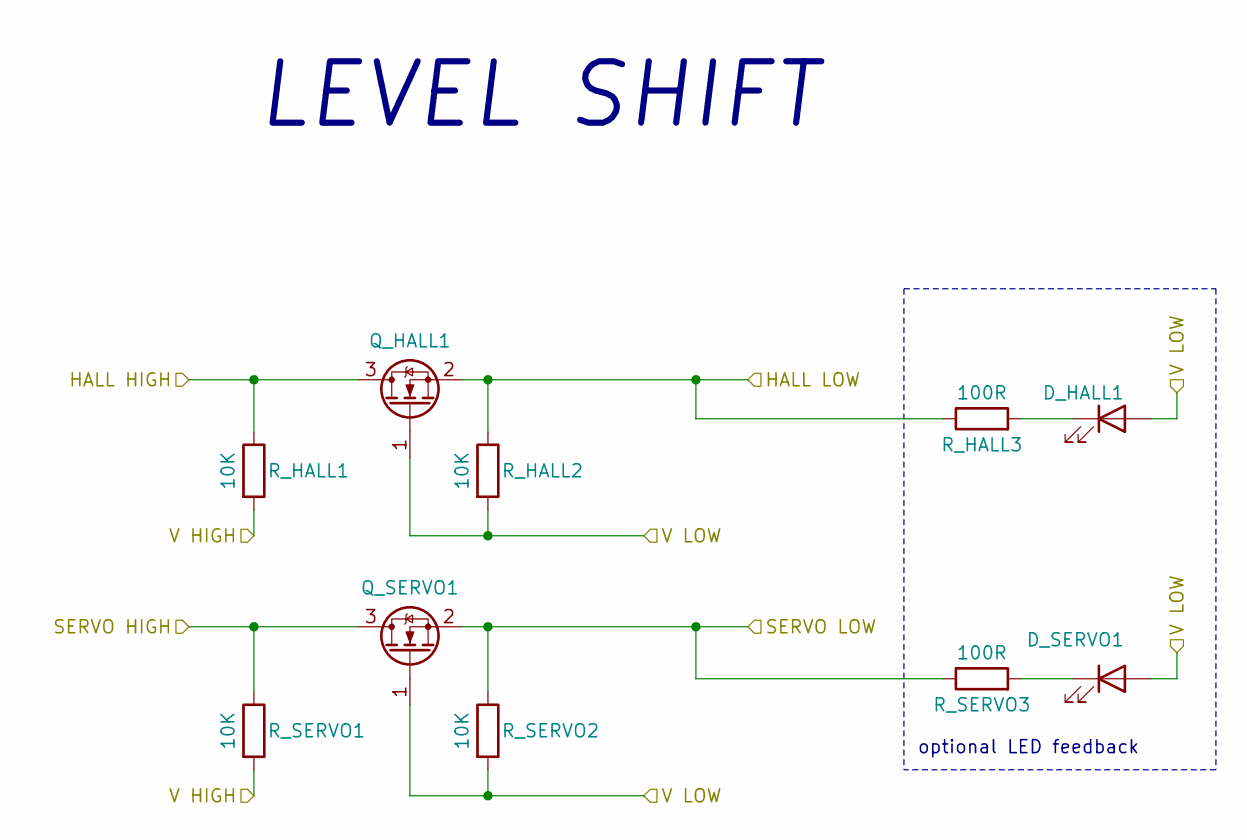
[picture p15: schematic levelshift.kicad_sch, E-TKT v2.0 BETA]

Parts:
D_HALL1: LED white; LED_0603_1608Metric_Pad1.05x0.95mm_HandSolder; Mouser OK
D_SERVO1: LED white; LED_0603_1608Metric_Pad1.05x0.95mm_HandSolder; Mouser OK
Q_HALL1: BSS138LT3G; SOT-23_Handsoldering; Mouser OK
Q_SERVO1: BSS138LT3G; SOT-23_Handsoldering; Mouser OK
R_HALL1, R_HALL2: 10K; R_0603_1608Metric_Pad0.98x0.95mm_HandSolder; Mouser OK
R_HALL3: 100R; R_0603_1608Metric_Pad0.98x0.95mm_HandSolder; Mouser OK
R_SERVO1, R_SERVO2: 10K; R_0603_1608Metric_Pad0.98x0.95mm_HandSolder; Mouser OK
R_SERVO3: 100R; R_0603_1608Metric_Pad0.98x0.95mm_HandSolder; Mouser OK

Connections:
+3.3V: D_HALL1.2 (A), D_SERVO1.2 (A), Q_HALL1.1 (G), Q_SERVO1.1 (G), R_HALL2.2, R_SERVO2.2; also elsewhere on the board
+6V: R_HALL1.2, R_SERVO1.2; also elsewhere on the board
HALL: Q_HALL1.3 (D), R_HALL1.1; also elsewhere on the board
IO14 SERVO: Q_SERVO1.2 (S), R_SERVO2.1, R_SERVO3.1; also elsewhere on the board
IO34 HALL: Q_HALL1.2 (S), R_HALL2.1, R_HALL3.1; also elsewhere on the board
unnamed: D_HALL1.1 (K), R_HALL3.2
unnamed: D_SERVO1.1 (K), R_SERVO3.2
SERVO: Q_SERVO1.3 (D), R_SERVO1.1; also elsewhere on the board

Notes on the sheet:
optional LED feedback
LEVEL SHIFT

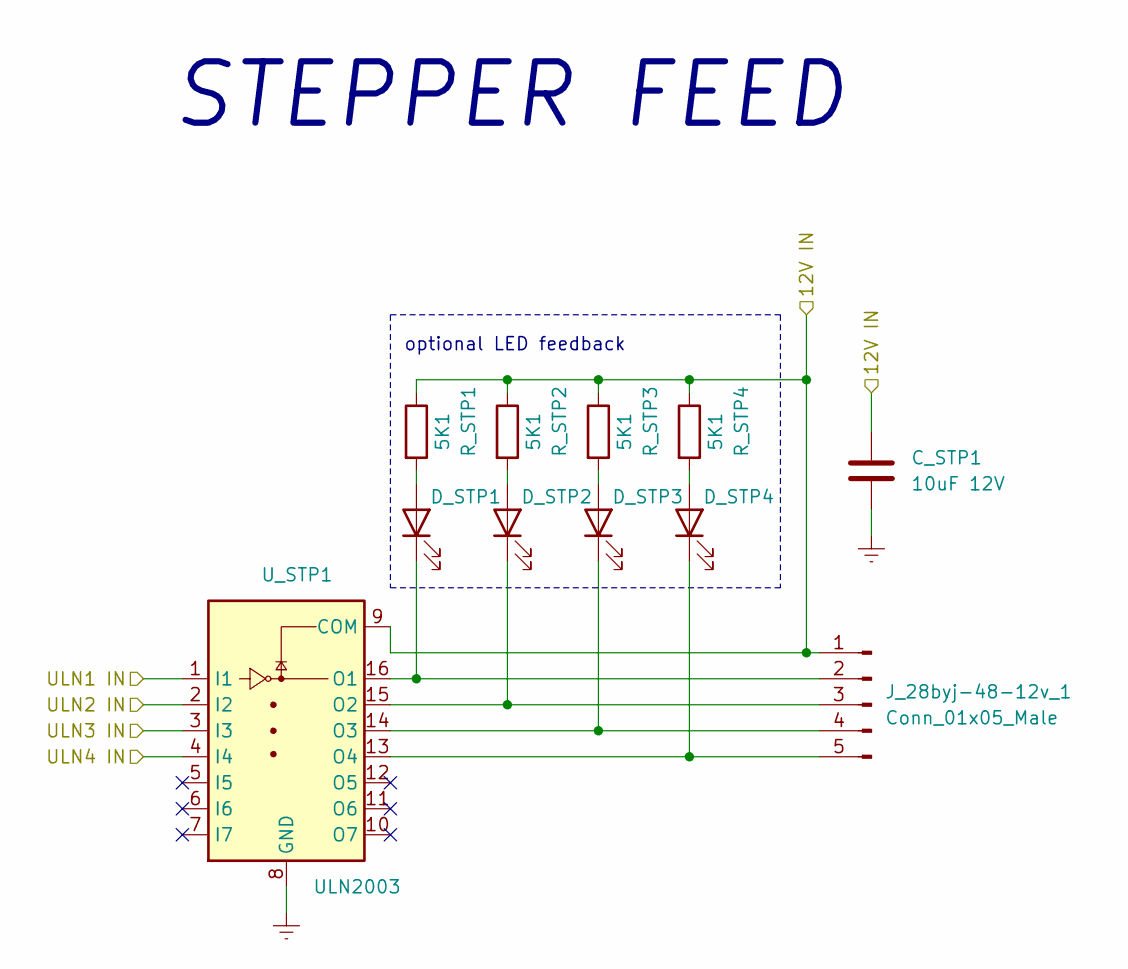
[picture p16: schematic feedstepper.kicad_sch, E-TKT v2.0 BETA]

Parts:
C_STP1: 10uF 12V; C_0603_1608Metric_Pad1.08x0.95mm_HandSolder; Mouser OK
D_STP1, D_STP2, D_STP3, D_STP4: LED white; LED_0603_1608Metric_Pad1.05x0.95mm_HandSolder; Mouser OK
J_28byj-48-12v_1: Conn_01x05_Male; PinHeader_1x05_P2.54mm_Vertical; Mouser OK
R_STP1, R_STP2, R_STP3, R_STP4: 5K1; R_0603_1608Metric_Pad0.98x0.95mm_HandSolder; Mouser OK
U_STP1: ULN2003; SOIC-16_3.9x9.9mm_P1.27mm; Mouser OK

Connections:
+12V: C_STP1.2, J_28byj-48-12v_1.1, R_STP1.1, R_STP2.1, R_STP3.1, R_STP4.1, U_STP1.9 (COM); also elsewhere on the board
GNDREF: C_STP1.1, U_STP1.8 (GND); also elsewhere on the board
IO2 ULN 3: U_STP1.3 (I3); also elsewhere on the board
IO4 ULN 2: U_STP1.2 (I2); also elsewhere on the board
IO15 ULN 1: U_STP1.1 (I1); also elsewhere on the board
IO16 ULN 4: U_STP1.4 (I4); also elsewhere on the board
unnamed: D_STP1.2 (A), R_STP1.2
unnamed: D_STP1.1 (K), J_28byj-48-12v_1.2, U_STP1.16 (O1)
unnamed: D_STP2.2 (A), R_STP2.2
unnamed: D_STP2.1 (K), J_28byj-48-12v_1.3, U_STP1.15 (O2)
unnamed: D_STP3.2 (A), R_STP3.2
unnamed: D_STP3.1 (K), J_28byj-48-12v_1.4, U_STP1.14 (O3)
unnamed: D_STP4.2 (A), R_STP4.2
unnamed: D_STP4.1 (K), J_28byj-48-12v_1.5, U_STP1.13 (O4)

Notes on the sheet:
optional LED feedback
STEPPER FEED

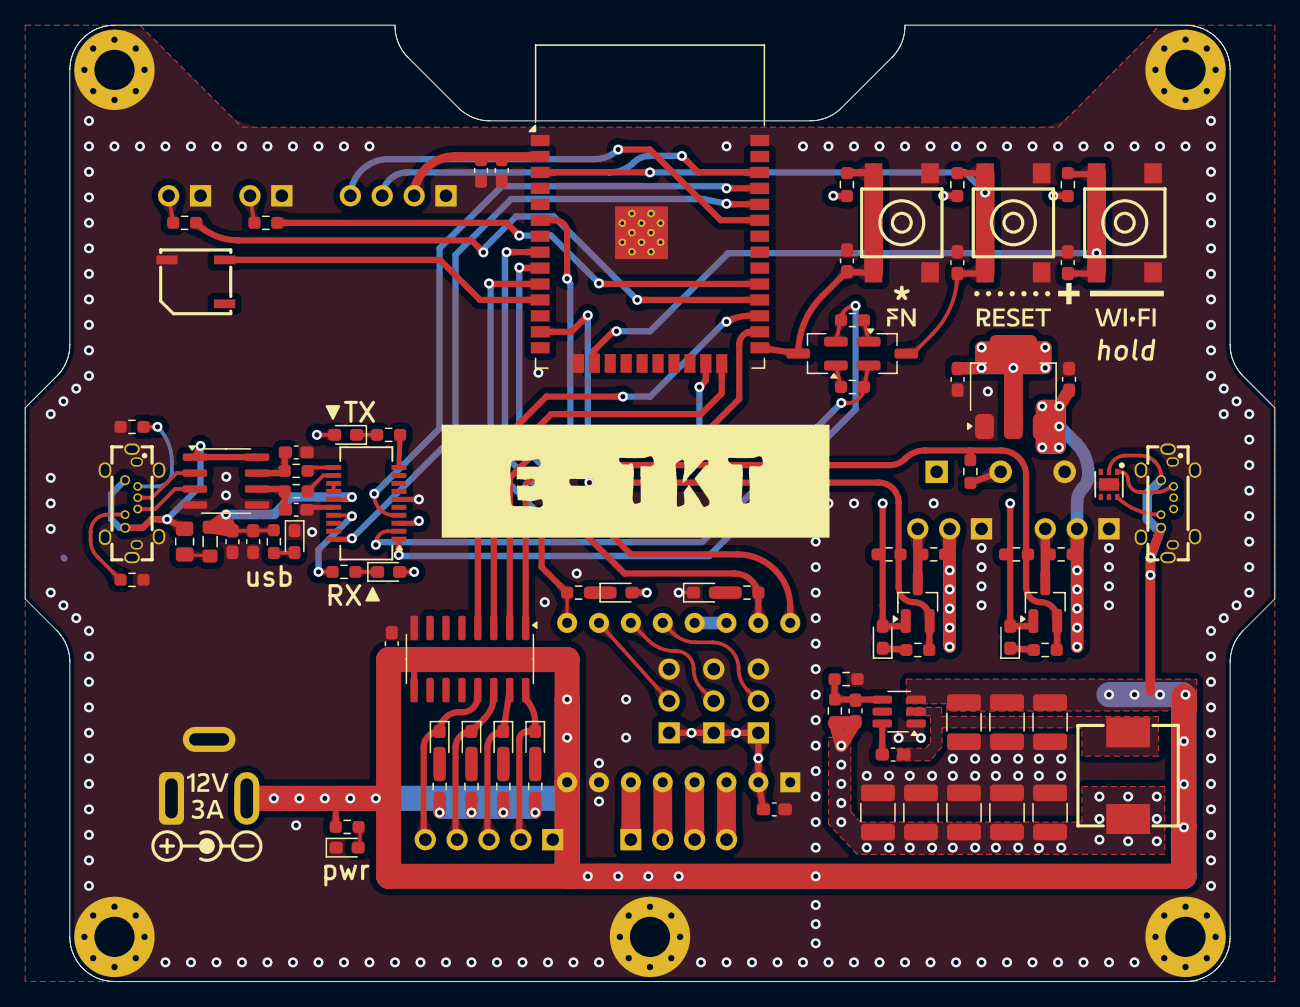
[picture p17: board e-tkt.kicad_pcb from above]

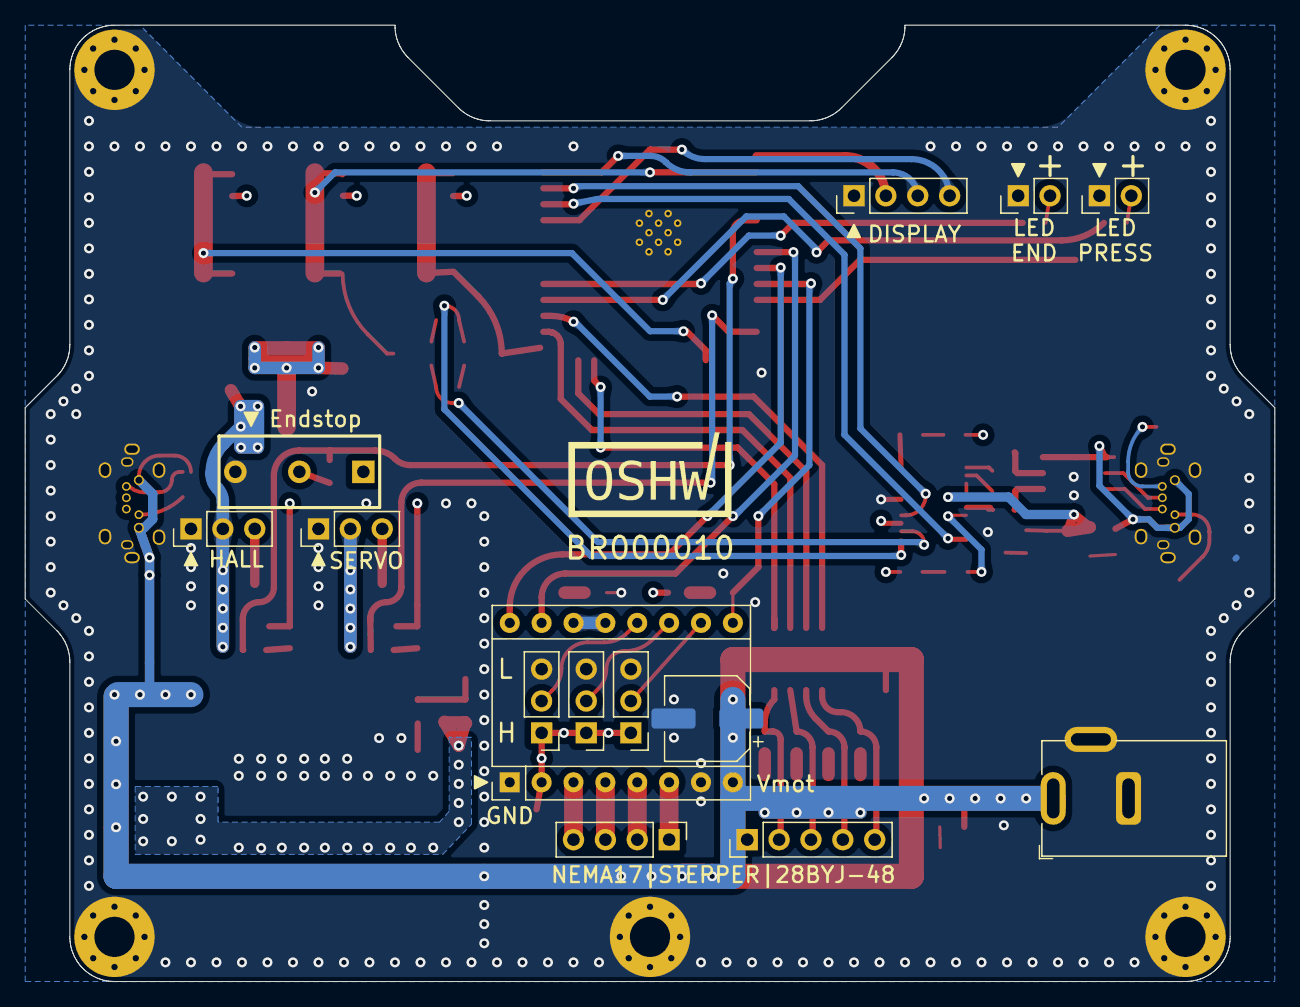
[picture p18: board e-tkt.kicad_pcb from below]

Board: 4 copper layers, 99.6 x 76.2 mm, 104 parts (14 on the bottom side), 75 nets.
