probably-Erwins-Cat/E-TKT/(commit log)

2025-10-15 BETA first upload
    nothing major done here:
    * updated KiCAD files to v9
    * removed alternative 6v feed-in. The proposed buck converter is fine.
    * added to all components LCSC component IDs. With this, exporting the project as gerber files also automatically creates correct BOM for JLCPCB manufacturing
    *
    [boot.kicad_sch, charstepper.kicad_sch, connectors.kicad_sch, e-tkt.kicad_pcb, e-tkt.kicad_sch, feedstepper.kicad_sch, levelshift.kicad_sch, mcu.kicad_sch]
2025-10-15 Added CAD, cleaned up KiCAD some more
    Added a FreeCAD Assembly. This will serve for minor updated to the printable parts.
    Updated USB-C component to standard KiCAD libary-integrated version, because the pinout of the schematic symbol was messing with the pinout of the footprint
    exported the PCB as step so it could be imported to FreeCAD
    [E-TKT.FCStd, PCB.step, boot.kicad_sch, e-tkt.kicad_pcb, e-tkt.kicad_sch, power12v.kicad_sch, power6v.kicad_sch, usb.kicad_sch]
2025-10-16 Updated A_bottom in FreeCAD
    added pockets for M3 nuts, added pockets for electronics cover
    started to optimize pcb footprint layout and voltage reference planes
    [E-TKT.FCStd, charstepper.kicad_sch, e-tkt.kicad_pcb]
2025-10-16 Minor adjustments of CAD and EDA
    [E-TKT.FCStd, boot.kicad_sch, e-tkt.kicad_pcb]
2025-10-16 Updating KiCAD files
    some footprints in KicCAD v9 were updated versus v6 and threw warnings/errors. All footprints are now v9 compatible
    wiring from ESP32 pins was optimized
    layout of servo and hall level shift was optimized
    layer 3 was split in 6V plane around the DCDC and 3V3 plane around everywhere else
    [E-TKT.FCStd, e-tkt.kicad_pcb]
2025-10-20 Decluttering traces and Compactifying Part placement
    many parts have been place in a compact format,
    footprint layout optimized for function and visuals
    [e-tkt.kicad_pcb]
2025-10-20 USB-C PD added
    in parallel to DC jack, realized via HUSB237
    [e-tkt.kicad_pcb, power12v.kicad_sch]
2025-10-21 Updated USB-C PD layout and zoning
    [e-tkt.kicad_pcb]
2025-10-21 Optimized alignment of USB-C socket
    so that there is more tolerance for printed parts
    [E-TKT.FCStd, PCB-V2-BETA.step, e-tkt.kicad_pcb, power12v.kicad_sch]
2025-10-21 pillars F G optimized
    for optional electronics cover and added M3 nut slots
    [E-TKT.FCStd, e-tkt.kicad_pcb]
2025-10-21 added pillars with nut pocket
    [E-TKT.FCStd, PCB-V2-BETA.step]
2025-10-22 Added endstop
    added footprint for a microswitch with roller as enstop. updated the CAD correspondingly by adding M4 hole in the nema wheel hub for an M4 12mm/16mm set screw (the ones with a pointy end).
    [E-TKT.FCStd, PCB-V2-BETA.step, connectors.kicad_sch, e-tkt.kicad_pcb, power12v.kicad_sch, usb.kicad_sch]
2025-10-23 sturdyfy E-TKT
    [E-TKT.FCStd, connectors.kicad_sch, e-tkt.kicad_pcb, power12v.kicad_sch, usb.kicad_sch]
2025-10-23 Sturdify CAD
    [E-TKT.FCStd]
2025-10-23 sturdify again
    [E-TKT.FCStd, e-tkt.kicad_pcb]
2025-10-23 JLC export added, LCSC numbers updated
    [bom.csv, charstepper.kicad_sch, connectors.kicad_sch, designators.csv, e-tkt.kicad_pcb, feedstepper.kicad_sch, positions.csv, power12v.kicad_sch]
2025-10-24 Updated layout of schematic symbol's text
    [boot.kicad_sch, charstepper.kicad_sch, connectors.kicad_sch, e-tkt.kicad_pcb, feedstepper.kicad_sch, levelshift.kicad_sch, power12v.kicad_sch, serial.kicad_sch]
